Carlos-Santos-prog/Beatmaker/mecanica/BeatMaker/BeatMaker/3x4/BeatMaker_12Pads.SLDASM

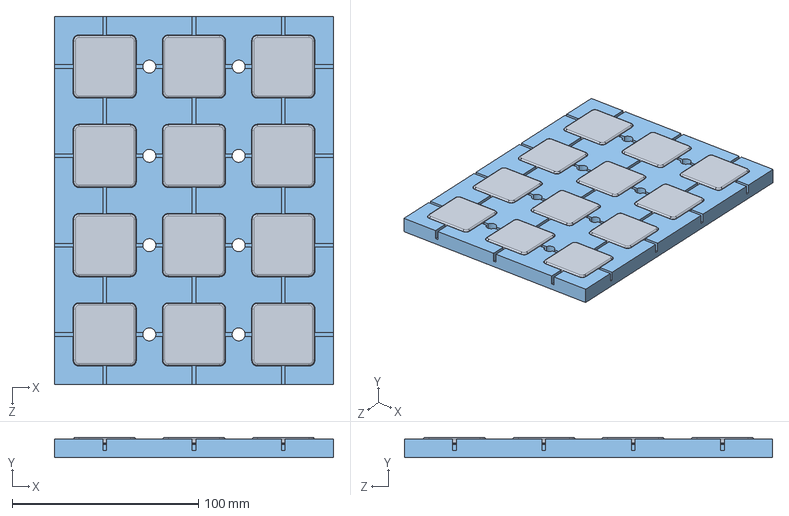
[picture p2: CAD file, 2026-11-11]
mecanica/BeatMaker/BeatMaker/3x4/BeatMaker_12Pads.SLDASM
150.0 x 11.0 x 198.0 mm
BasePiezoElectricos12
Piezoelectric Disc_ x 12
BotonPrueba x 12
