Carlos-Santos-prog/Beatmaker/mecanica/BeatMaker/BeatMaker/4x4/BeatMaker_16Pads.SLDASM

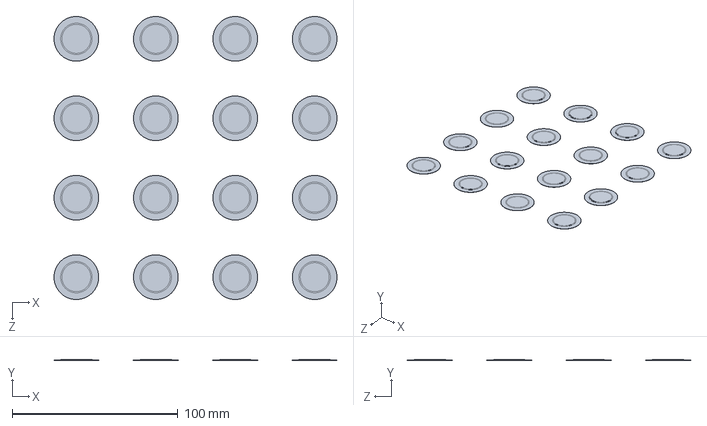
[picture p3: CAD file, 2026-11-11]
mecanica/BeatMaker/BeatMaker/4x4/BeatMaker_16Pads.SLDASM
171.0 x 0.3 x 171.0 mm
Piezoelectric Disc_ x 16
