Carlos-Santos-prog/Beatmaker/mecanica/BeatMaker/BeatMaker/Prueba/Prueba.SLDASM

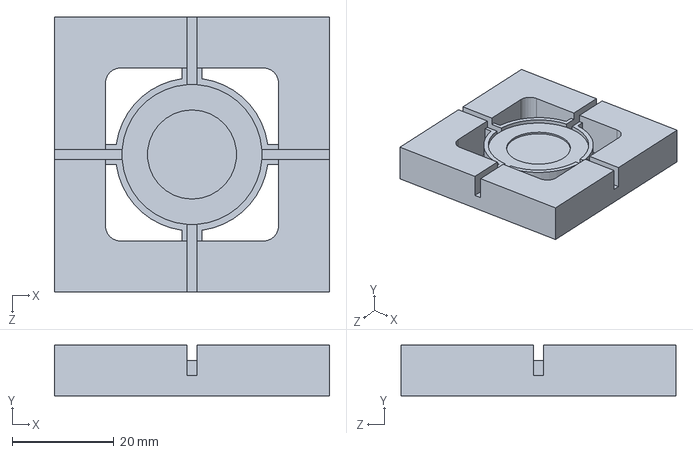
[picture p4: CAD file, 2026-11-11]
mecanica/BeatMaker/BeatMaker/Prueba/Prueba.SLDASM
54.0 x 10.0 x 54.0 mm
