Carlos-Santos-prog/Beatmaker/hardware/Fisico_00.DXF

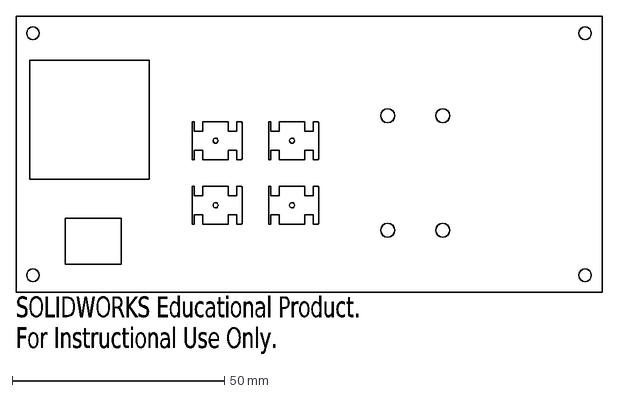
[picture p5: CAD file, 2026-11-13]
hardware/Fisico_00.DXF
SOLIDWORKS Educational Product.
For Instructional Use Only.
