Carlos-Santos-prog/Beatmaker/mecanica/0-96-oled-display-1.snapshot.1/0,96'' OLED Display.step

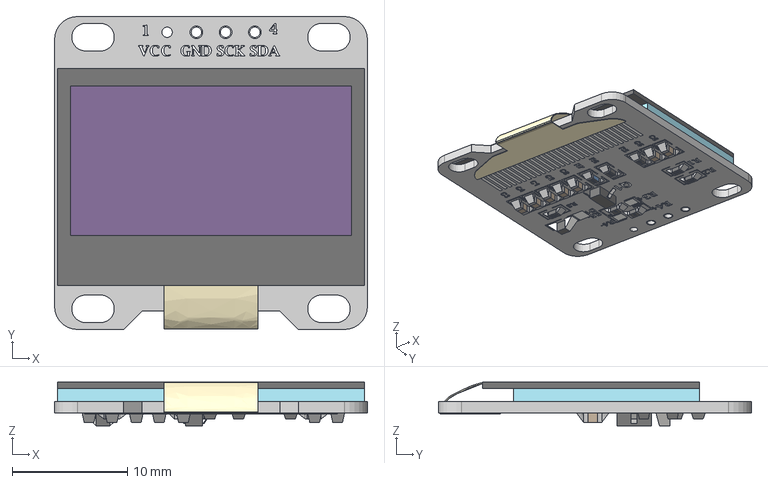
[picture p6: CAD file, 2026-11-11]
mecanica/0-96-oled-display-1.snapshot.1/0,96'' OLED Display.step
27.2 x 27.2 x 3.79 mm
