Carlos-Santos-prog/Beatmaker/mecanica/9mm-insulated-shaft-potentiometer-vertical-type-1.snapshot.5/models3d/Potentiometers/R-0904N-L-20KS-black.step

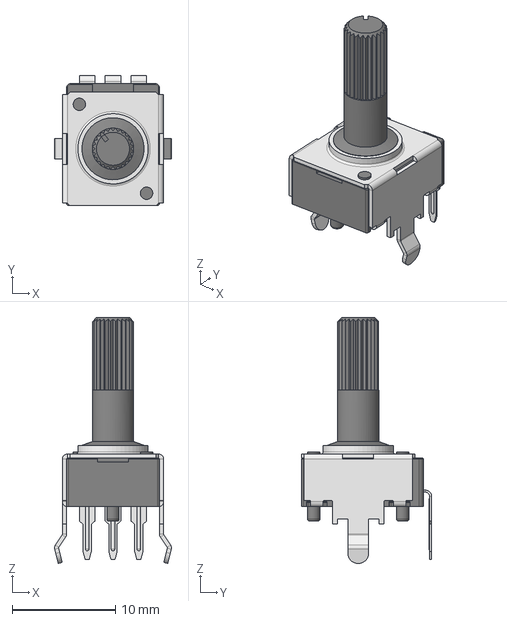
[picture p7: CAD file, 2026-11-11]
mecanica/9mm-insulated-shaft-potentiometer-vertical-type-1.snapshot.5/models3d/Potentiometers/R-0904N-L-20KS-black.step
11.3 x 12.6 x 23.8 mm
