Carlos-Santos-prog/Beatmaker/mecanica/BeatMaker/BeatMaker/Case.SLDPRT

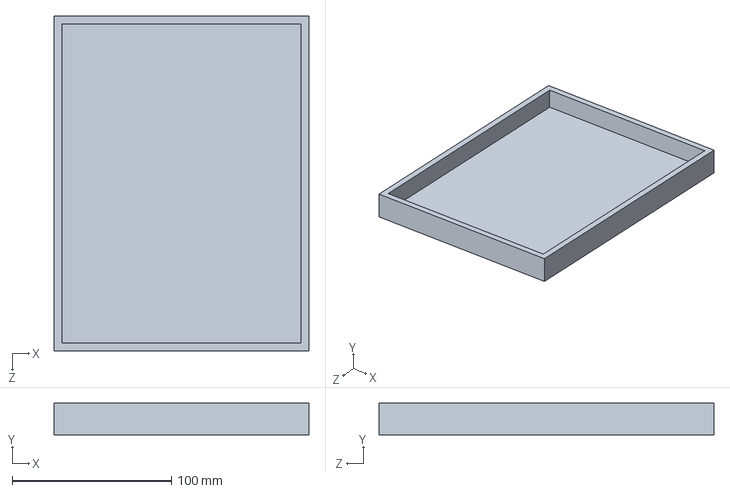
[picture p8: CAD file, 2026-11-11]
mecanica/BeatMaker/BeatMaker/Case.SLDPRT
160.0 x 20.0 x 210.0 mm
