Carlos-Santos-prog/Beatmaker/mecanica/BeatMaker/BeatMaker/Prueba/BotonPrueba.SLDPRT

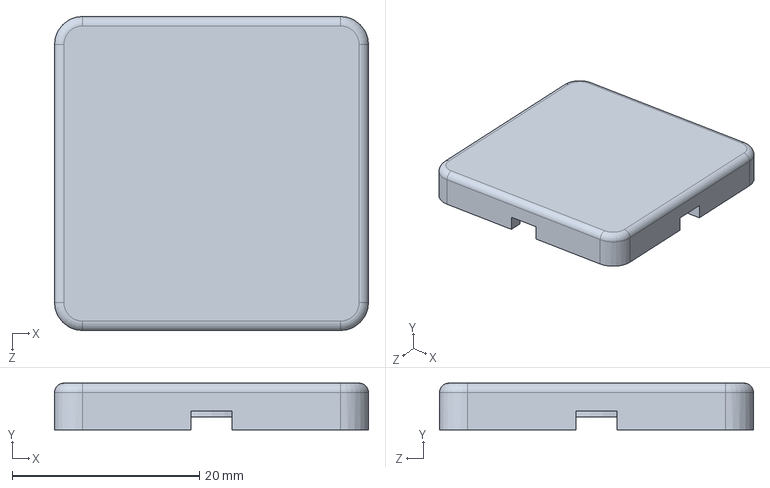
[picture p9: CAD file, 2026-11-11]
mecanica/BeatMaker/BeatMaker/Prueba/BotonPrueba.SLDPRT
33.5 x 5.00 x 33.5 mm
