Carlos-Santos-prog/Beatmaker/mecanica/rotary-encoders-1.snapshot.1/rotary+encoder_14mm_hole_spc.stp

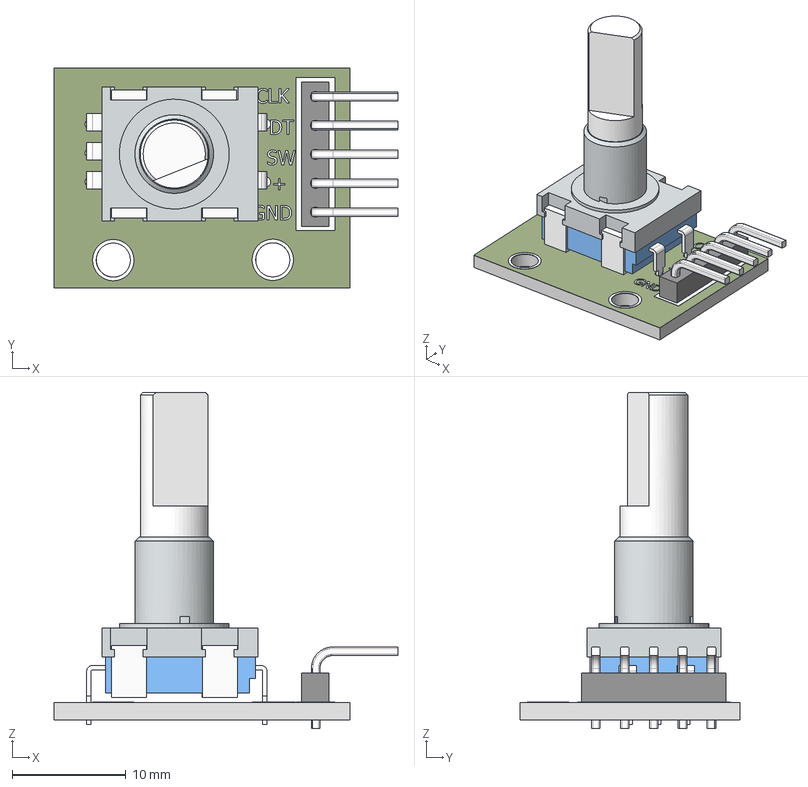
[picture p10: CAD file, 2026-11-11]
mecanica/rotary-encoders-1.snapshot.1/rotary+encoder_14mm_hole_spc.stp
30.2 x 19.3 x 29.6 mm
pcb
mtg flange
body_encoder
5 pin header
90d pin_header x 5
decal_encoder
pins_encoder body_2 x 5
shaft_encoder
