Carlos-Santos-prog/Beatmaker/mecanica/BeatMaker/BeatMaker/3x4/BasePiezoElectricos12.SLDPRT

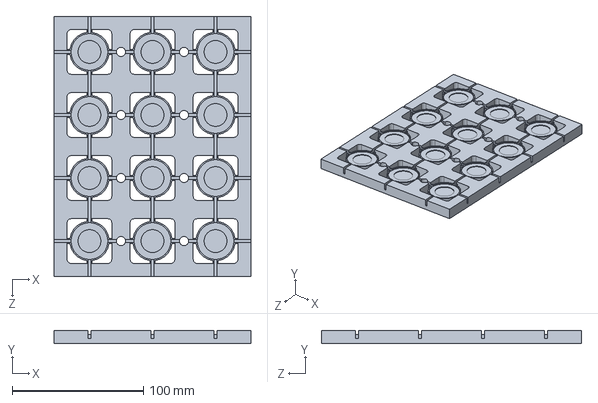
[picture p11: CAD file, 2026-11-11]
mecanica/BeatMaker/BeatMaker/3x4/BasePiezoElectricos12.SLDPRT
150.0 x 10.0 x 198.0 mm
