Carlos-Santos-prog/Beatmaker/mecanica/BeatMaker/BeatMaker/4x4/BasePiezoElectricos16.SLDPRT

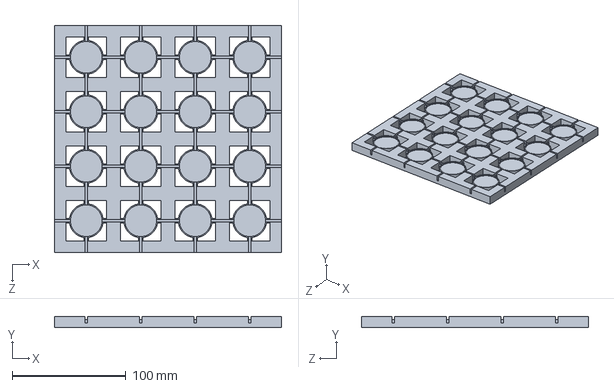
[picture p12: CAD file, 2026-11-11]
mecanica/BeatMaker/BeatMaker/4x4/BasePiezoElectricos16.SLDPRT
200.0 x 10.0 x 200.0 mm
