Carlos-Santos-prog/Beatmaker/mecanica/BeatMaker/BeatMaker/Piezoelectric Disc_.SLDPRT

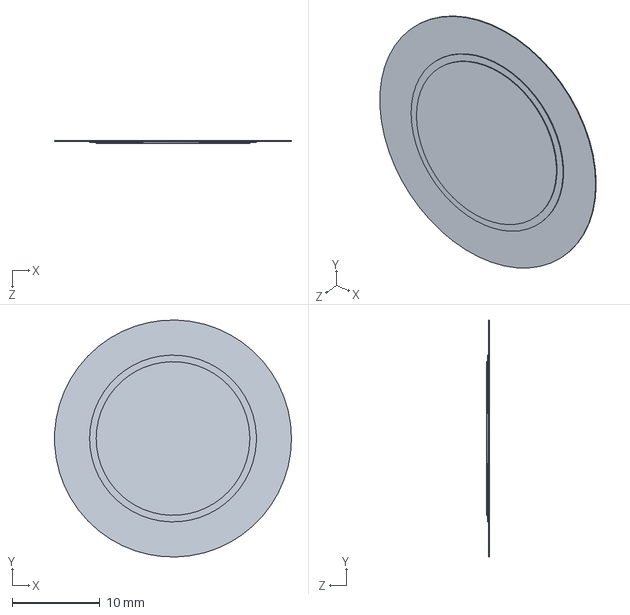
[picture p13: CAD file, 2026-11-11]
mecanica/BeatMaker/BeatMaker/Piezoelectric Disc_.SLDPRT
27.0 x 27.0 x 0.3 mm
