Carlos-Santos-prog/Beatmaker/mecanica/Calcasa.SLDPRT

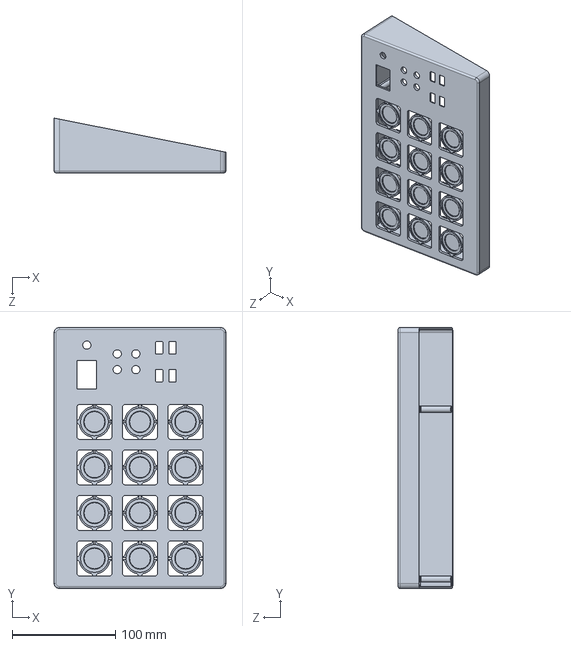
[picture p14: CAD file, 2026-11-13]
mecanica/Calcasa.SLDPRT
166.0 x 252.2 x 53.0 mm
