Carlos-Santos-prog/Beatmaker/mecanica/BeatMaker/BeatMaker/3x4/Boton.SLDPRT

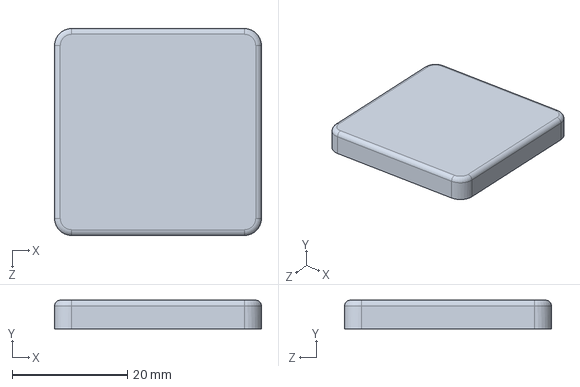
[picture p15: CAD file, 2026-11-11]
mecanica/BeatMaker/BeatMaker/3x4/Boton.SLDPRT
36.0 x 5.00 x 36.0 mm
