Carlos-Santos-prog/Beatmaker/mecanica/GomaBoton.SLDPRT

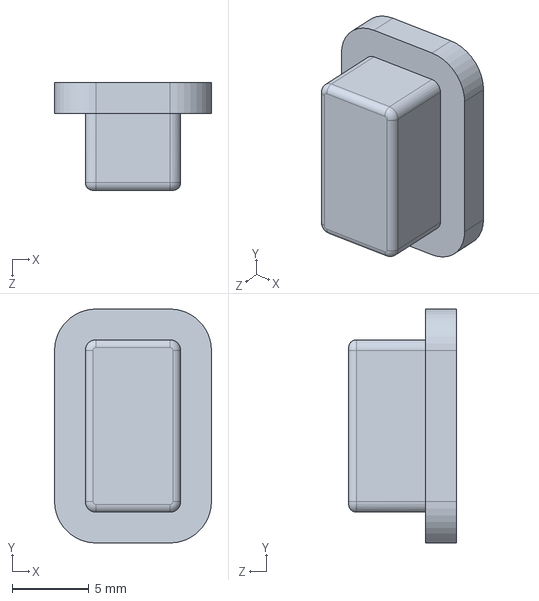
[picture p16: CAD file, 2026-11-11]
mecanica/GomaBoton.SLDPRT
10.2 x 15.2 x 7.00 mm
