Carlos-Santos-prog/Beatmaker/mecanica/Fisico_00.SLDASM

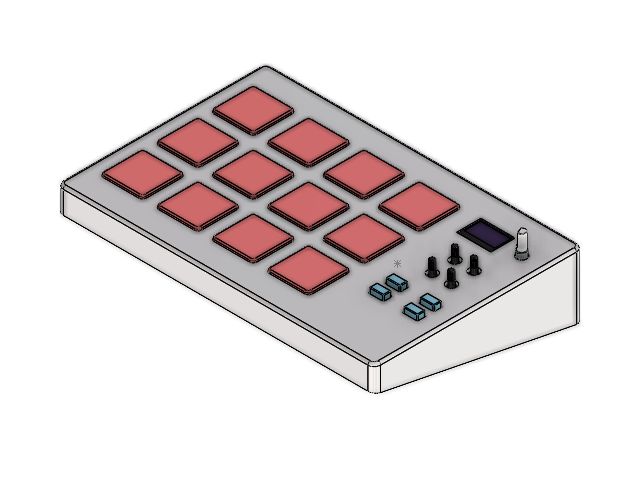
[picture p17: CAD file, 2026-11-13]
mecanica/Fisico_00.SLDASM
Calcasa
pcb.step
eBom-FreeParts.step
mtg flange.stp
body_encoder.stp
body_2.stp x 4
pins_encoder body_2.stp x 5
shaft_encoder.stp
R-0904N-L-20KS.step x 4
GomaBoton x 4
BotonPrueba x 12
Piezoelectric Disc_
