Carlos-Santos-prog/Beatmaker/(list of files, cad)

Other CAD files:
mecanica/9mm-insulated-shaft-potentiometer-vertical-type-1.snapshot.5/models3d/Potentiometers/R-0904N-L-20KS.step
mecanica/BeatMaker/BeatMaker/Prueba/BasePiezoPrueba.SLDPRT
mecanica/9mm-insulated-shaft-potentiometer-vertical-type-1.snapshot.5/models3d/Potentiometers/R-0904N-L-20KS-green.step
