Carlos-Santos-prog/Beatmaker/hardware/Indutrial/Indutrial.kicad_pcb

## KiCad design hardware/Indutrial/Indutrial.kicad_pcb (2026-11-13)

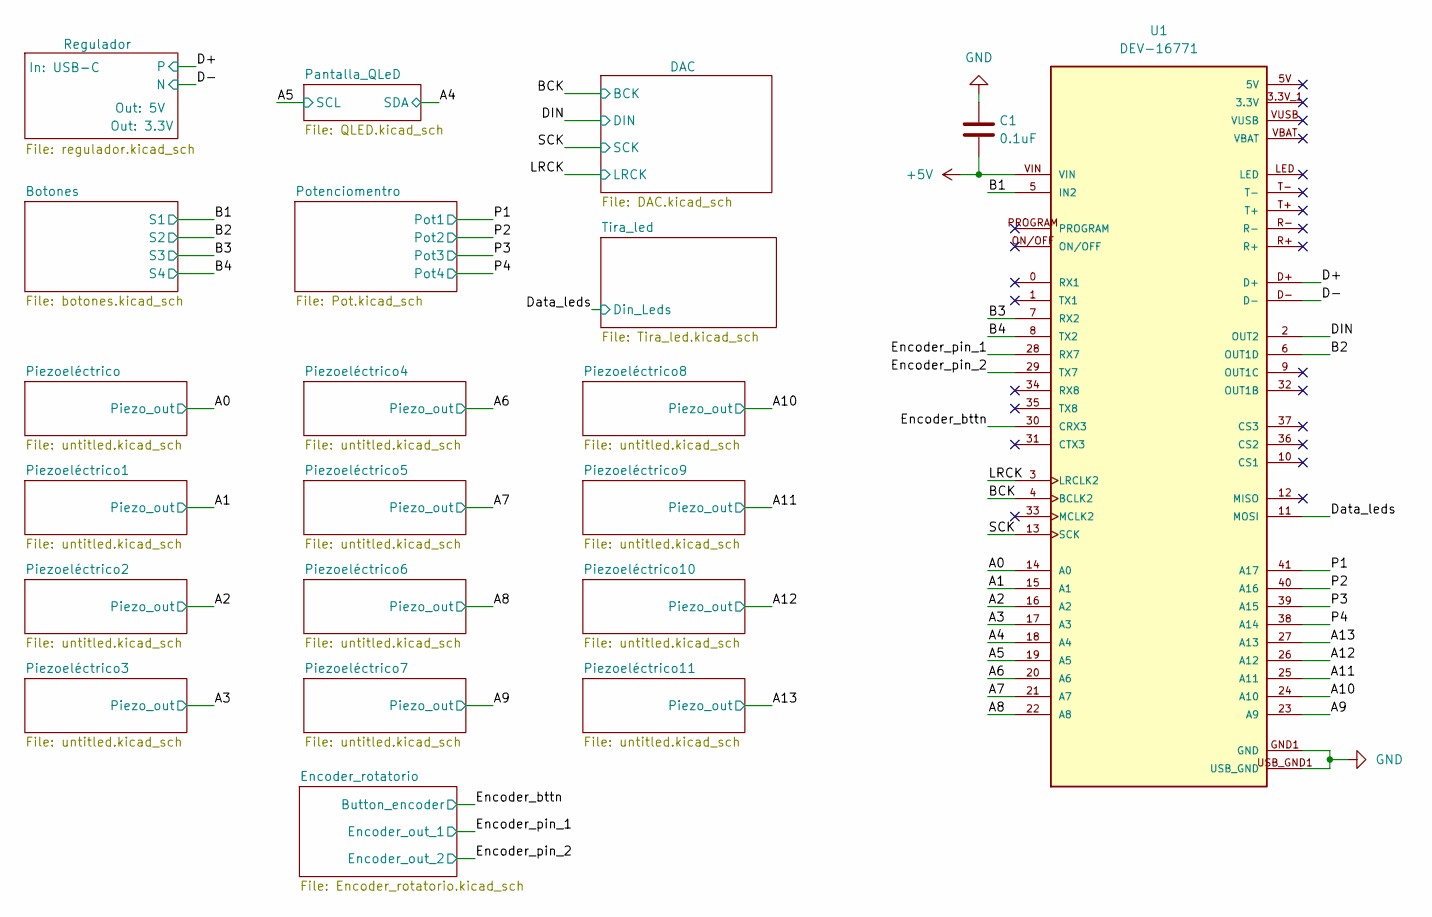
[picture p24: schematic Indutrial.kicad_sch]

Parts:
C1: 0.1uF; C_0603_1608Metric
U1: DEV-16771; MODULE_DEV-16771; MPN DEV-16771

Connections:
+5V: C1.2, U1.VIN; also elsewhere on the board
/A0: U1.14 (A0); also elsewhere on the board
/A1: U1.15 (A1); also elsewhere on the board
/A2: U1.16 (A2); also elsewhere on the board
/A3: U1.17 (A3); also elsewhere on the board
/A4: U1.18 (A4); also elsewhere on the board
/A5: U1.19 (A5); also elsewhere on the board
/A6: U1.20 (A6); also elsewhere on the board
/A7: U1.21 (A7); also elsewhere on the board
/A8: U1.22 (A8); also elsewhere on the board
/A9: U1.23 (A9); also elsewhere on the board
/A10: U1.24 (A10); also elsewhere on the board
/A11: U1.25 (A11); also elsewhere on the board
/A12: U1.26 (A12); also elsewhere on the board
/A13: U1.27 (A13); also elsewhere on the board
/B1: U1.5 (IN2); also elsewhere on the board
/B2: U1.6 (OUT1D); also elsewhere on the board
/B3: U1.7 (RX2); also elsewhere on the board
/B4: U1.8 (TX2); also elsewhere on the board
/BCK: U1.4 (BCLK2); also elsewhere on the board
/D+: U1.D+; also elsewhere on the board
/D-: U1.D-; also elsewhere on the board
/DIN: U1.2 (OUT2); also elsewhere on the board
/Data_leds: U1.11 (MOSI); also elsewhere on the board
/Encoder_bttn: U1.30 (CRX3); also elsewhere on the board
/Encoder_pin_1: U1.28 (RX7); also elsewhere on the board
/Encoder_pin_2: U1.29 (TX7); also elsewhere on the board
/LRCK: U1.3 (LRCLK2); also elsewhere on the board
/P1: U1.41 (A17); also elsewhere on the board
/P2: U1.40 (A16); also elsewhere on the board
/P3: U1.39 (A15); also elsewhere on the board
/P4: U1.38 (A14); also elsewhere on the board
/SCK: U1.13 (SCK); also elsewhere on the board
GND: C1.1, U1.GND1 (GND), U1.GND2 (GND), U1.GND3 (GND), U1.GND4 (GND), U1.GND5 (GND), U1.USB_GND1 (USB_GND), U1.USB_GND2 (USB_GND); also elsewhere on the board

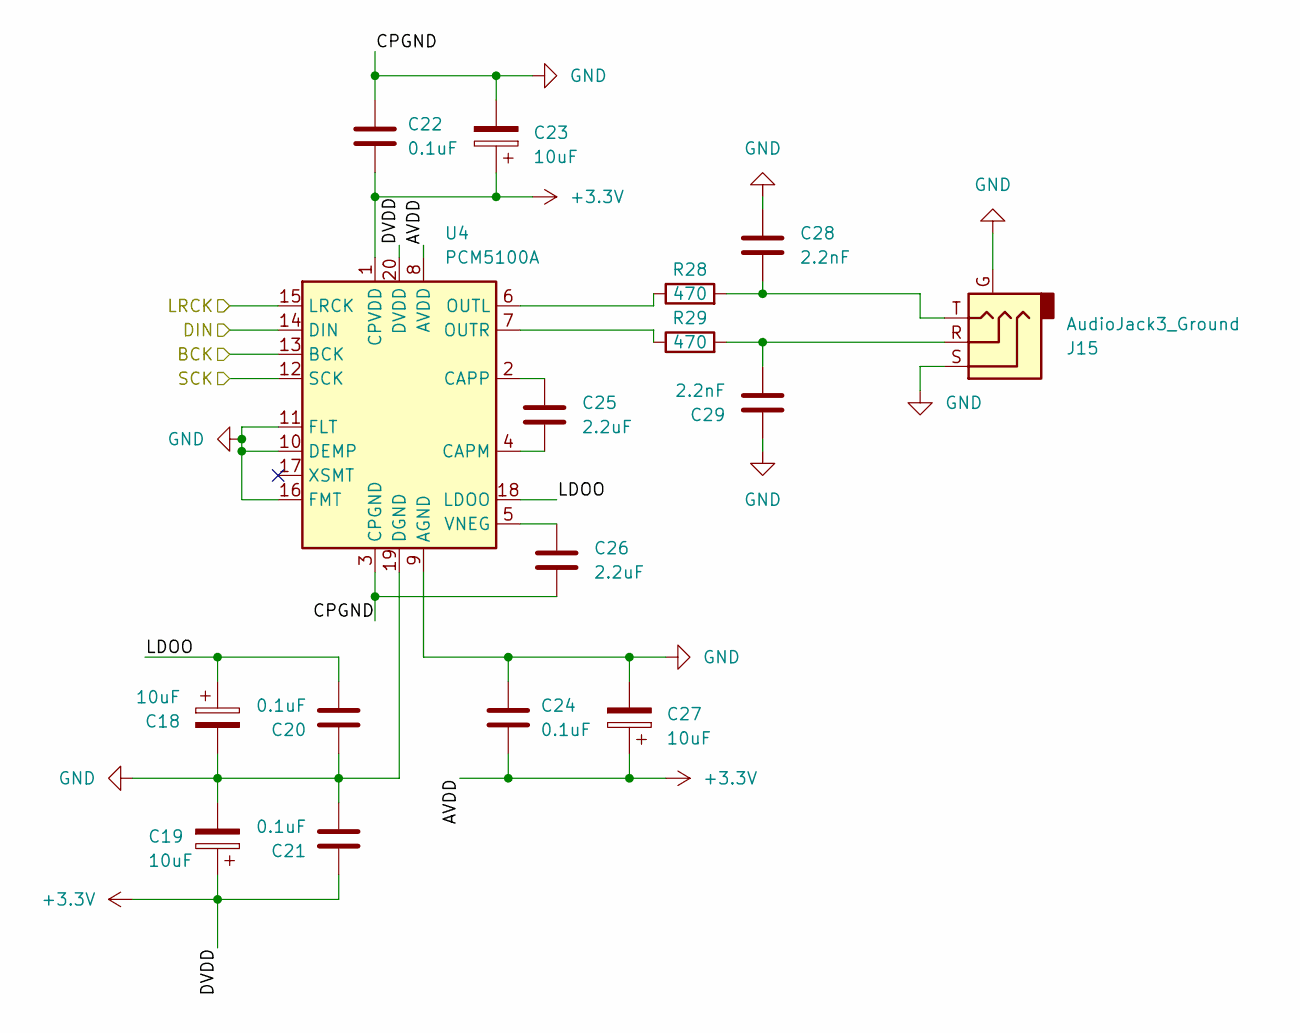
[picture p25: schematic DAC.kicad_sch]

Parts:
C18, C19: 10uF; C_1206_3216Metric
C20, C21, C22, C24: 0.1uF; C_0603_1608Metric
C23, C27: 10uF; CP_EIA-3216-18_Kemet-A
C25, C26: 2.2uF; C_0805_2012Metric
C28, C29: 2.2nF; C_0805_2012Metric_Pad1.18x1.45mm_HandSolder
J15: AudioJack3_Ground; Jack_3.5mm_CUI_SJ1-3524N_Horizontal
R28, R29: 470; R_1206_3216Metric
U4: PCM5100A; TSSOP-20_4.4x6.5mm_P0.65mm

Connections:
+3.3V: C19.1, C21.2, C22.1, C23.1, C24.1, C27.1, U4.1 (CPVDD), U4.8 (AVDD), U4.20 (DVDD); also elsewhere on the board
/BCK: U4.13 (BCK); also elsewhere on the board
/DAC/LDOO: C18.1, C20.1, U4.18 (LDOO)
/DIN: U4.14 (DIN); also elsewhere on the board
/LRCK: U4.15 (LRCK); also elsewhere on the board
/SCK: U4.12 (SCK); also elsewhere on the board
GND: C18.2, C19.2, C20.2, C21.1, C22.2, C23.2, C24.2, C26.1, C27.2, C28.1, C29.1, J15.G, J15.S, U4.3 (CPGND), U4.9 (AGND), U4.10 (DEMP), U4.11 (FLT), U4.16 (FMT), U4.19 (DGND); also elsewhere on the board
unnamed: C28.2, J15.T, R28.2
unnamed: C29.2, J15.R, R29.2
unnamed: C25.1, U4.4 (CAPM)
unnamed: C25.2, U4.2 (CAPP)
unnamed: R28.1, U4.6 (OUTL)
unnamed: R29.1, U4.7 (OUTR)
unnamed: C26.2, U4.5 (VNEG)

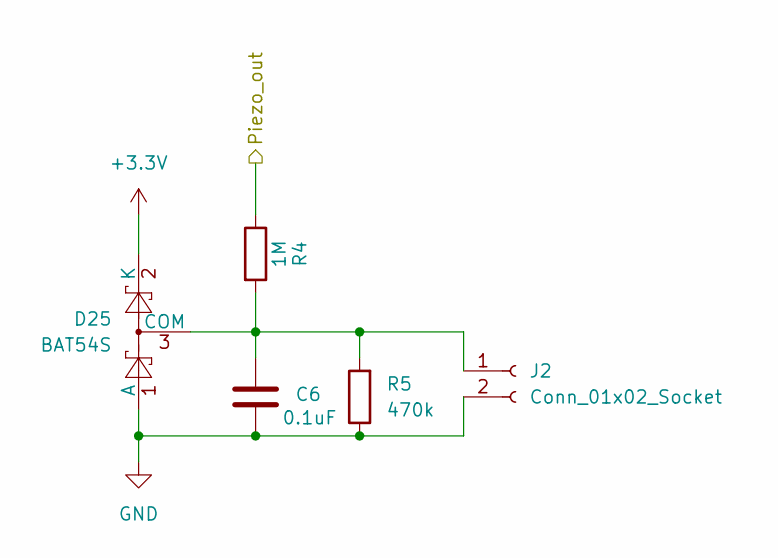
[picture p26: schematic untitled.kicad_sch]

Parts:
C6: 0.1uF; C_0603_1608Metric
D25: BAT54S; SOT-23
J2: Conn_01x02_Socket; SolderWire-0.1sqmm_1x02_P3.6mm_D0.4mm_OD1mm
R4: 1M; R_0603_1608Metric
R5: 470k; R_0603_1608Metric

Connections:
+3.3V: D25.2 (K); also elsewhere on the board
/A0: R4.1; also elsewhere on the board
GND: C6.2, D25.1 (A), J2.2, R5.1; also elsewhere on the board
unnamed: C6.1, D25.3 (COM), J2.1, R4.2, R5.2

Parts of its further copies:
C7, C8, C9, C10, C11, C12, C13, C14, C15, C16, C17: 0.1uF; C_0603_1608Metric
D26, D27, D28, D29, D30, D31, D32, D33, D34, D35, D36: BAT54S; SOT-23
J3, J4, J5, J6, J7, J8, J9, J10, J11, J12, J13: Conn_01x02_Socket; SolderWire-0.1sqmm_1x02_P3.6mm_D0.4mm_OD1mm
R6, R8, R10, R12, R14, R16, R18, R20, R22, R24, R26: 1M; R_0603_1608Metric
R7, R9, R11, R13, R15, R17, R19, R21, R23, R25, R27: 470k; R_0603_1608Metric

Connections of its further copies:
+3.3V: D26.2 (K), D27.2 (K), D28.2 (K), D29.2 (K), D30.2 (K), D31.2 (K), D32.2 (K), D33.2 (K), D34.2 (K), D35.2 (K), D36.2 (K); also elsewhere on the board
/A1: R6.1; also elsewhere on the board
/A2: R8.1; also elsewhere on the board
/A3: R10.1; also elsewhere on the board
/A6: R12.1; also elsewhere on the board
/A7: R14.1; also elsewhere on the board
/A8: R16.1; also elsewhere on the board
/A9: R18.1; also elsewhere on the board
/A10: R20.1; also elsewhere on the board
/A11: R22.1; also elsewhere on the board
/A12: R24.1; also elsewhere on the board
/A13: R26.1; also elsewhere on the board
GND: C7.2, C8.2, C9.2, C10.2, C11.2, C12.2, C13.2, C14.2, C15.2, C16.2, C17.2, D26.1 (A), D27.1 (A), D28.1 (A), D29.1 (A), D30.1 (A), D31.1 (A), D32.1 (A), D33.1 (A), D34.1 (A), D35.1 (A), D36.1 (A), J3.2, J4.2, J5.2, J6.2, J7.2, J8.2, J9.2, J10.2, J11.2, J12.2, J13.2, R7.1, R9.1, R11.1, R13.1, R15.1, R17.1, R19.1, R21.1, R23.1, R25.1, R27.1; also elsewhere on the board
unnamed: C7.1, D26.3 (COM), J3.1, R6.2, R7.2
unnamed: C8.1, D27.3 (COM), J4.1, R8.2, R9.2
unnamed: C9.1, D28.3 (COM), J5.1, R10.2, R11.2
unnamed: C10.1, D29.3 (COM), J6.1, R12.2, R13.2
unnamed: C11.1, D30.3 (COM), J7.1, R14.2, R15.2
unnamed: C12.1, D31.3 (COM), J8.1, R16.2, R17.2
unnamed: C13.1, D32.3 (COM), J9.1, R18.2, R19.2
unnamed: C14.1, D33.3 (COM), J10.1, R20.2, R21.2
unnamed: C15.1, D34.3 (COM), J11.1, R22.2, R23.2
unnamed: C16.1, D35.3 (COM), J12.1, R24.2, R25.2
unnamed: C17.1, D36.3 (COM), J13.1, R26.2, R27.2

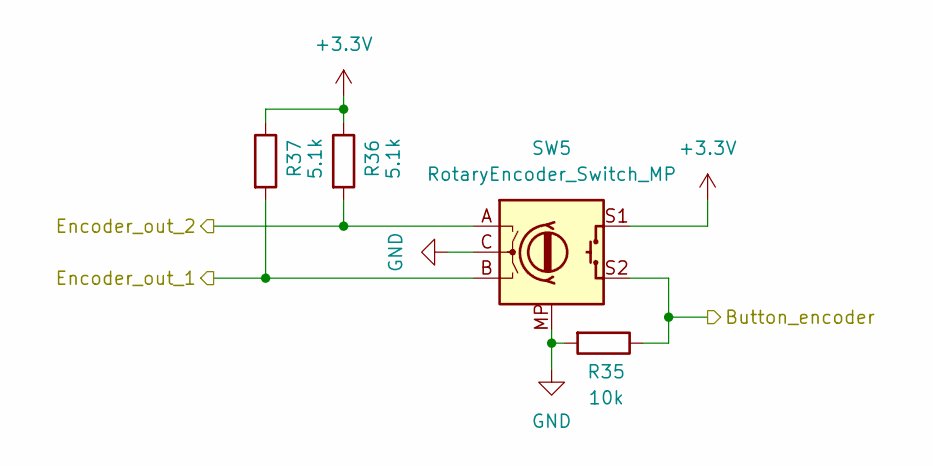
[picture p27: schematic Encoder_rotatorio.kicad_sch]

Parts:
R35: 10k; R_0603_1608Metric
R36, R37: 5.1k; R_0603_1608Metric
SW5: RotaryEncoder_Switch_MP; RotaryEncoder_Alps_EC11E-Switch_Vertical_H20mm

Connections:
+3.3V: R36.1, R37.1, SW5.S1; also elsewhere on the board
/Encoder_bttn: R35.1, SW5.S2; also elsewhere on the board
/Encoder_pin_1: R37.2, SW5.B; also elsewhere on the board
/Encoder_pin_2: R36.2, SW5.A; also elsewhere on the board
GND: R35.2, SW5.C, SW5.MP; also elsewhere on the board

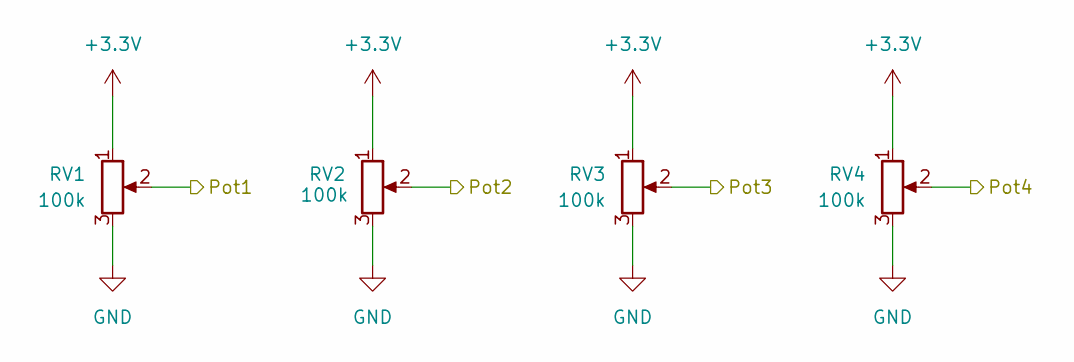
[picture p28: schematic Pot.kicad_sch]

Parts:
RV1, RV2, RV3, RV4: 100k; Potentiometer_Alpha_RD901F-40-00D_Single_Vertical

Connections:
+3.3V: RV1.1, RV2.1, RV3.1, RV4.1; also elsewhere on the board
/P1: RV1.2; also elsewhere on the board
/P2: RV2.2; also elsewhere on the board
/P3: RV3.2; also elsewhere on the board
/P4: RV4.2; also elsewhere on the board
GND: RV1.3, RV2.3, RV3.3, RV4.3; also elsewhere on the board

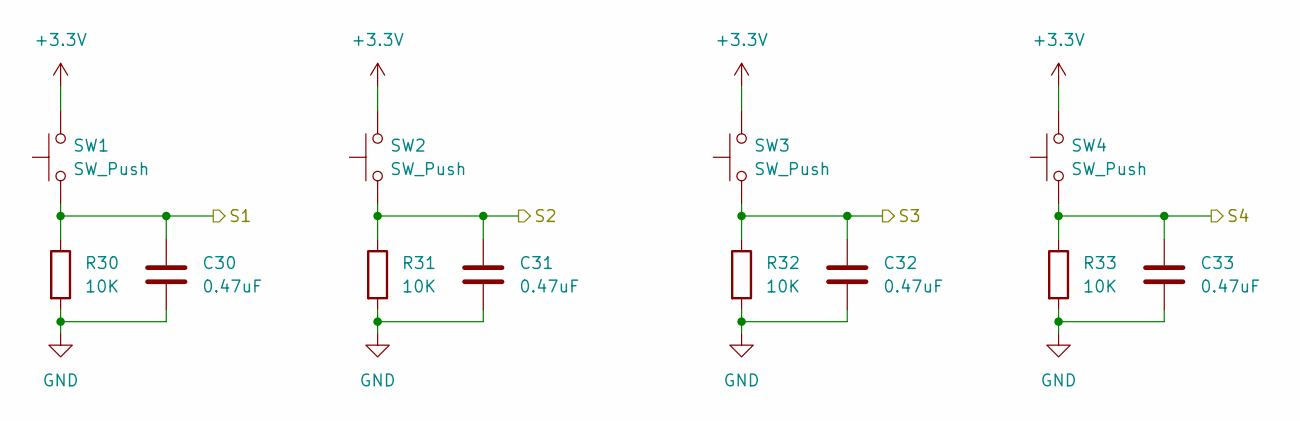
[picture p29: schematic botones.kicad_sch]

Parts:
C30, C31, C32, C33: 0.47uF; C_0805_2012Metric
R30, R31, R32, R33: 10K; R_0805_2012Metric
SW1, SW2, SW3, SW4: SW_Push; SW_PUSH_6mm

Connections:
+3.3V: SW1.2, SW2.2, SW3.2, SW4.2; also elsewhere on the board
/B1: C30.1, R30.1, SW1.1; also elsewhere on the board
/B2: C31.1, R31.1, SW2.1; also elsewhere on the board
/B3: C32.1, R32.1, SW3.1; also elsewhere on the board
/B4: C33.1, R33.1, SW4.1; also elsewhere on the board
GND: C30.2, C31.2, C32.2, C33.2, R30.2, R31.2, R32.2, R33.2; also elsewhere on the board

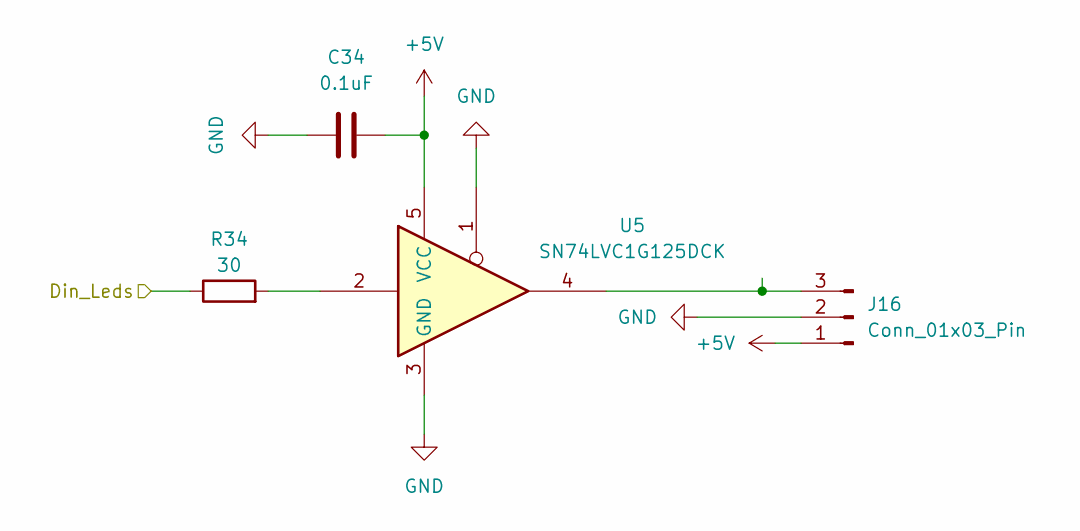
[picture p30: schematic Tira_led.kicad_sch]

Parts:
C34: 0.1uF; C_0805_2012Metric
J16: Conn_01x03_Pin; JST_EH_B3B-EH-A_1x03_P2.50mm_Vertical
R34: 30; R_1206_3216Metric
U5: SN74LVC1G125DCK; Texas_R-PDSO-G5_DCK-5

Connections:
+5V: C34.1, J16.1, U5.5 (VCC); also elsewhere on the board
/Data_leds: R34.1; also elsewhere on the board
GND: C34.2, J16.2, U5.1, U5.3 (GND); also elsewhere on the board
unnamed: J16.3, U5.4
unnamed: R34.2, U5.2

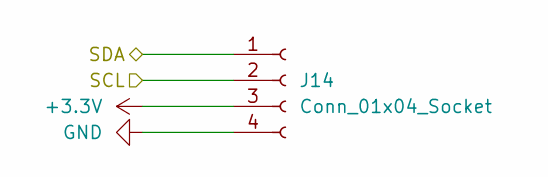
[picture p31: schematic QLED.kicad_sch]

Parts:
J14: Conn_01x04_Socket; PinSocket_1x04_P2.54mm_Vertical

Connections:
+3.3V: J14.3; also elsewhere on the board
/A4: J14.1; also elsewhere on the board
/A5: J14.2; also elsewhere on the board
GND: J14.4; also elsewhere on the board

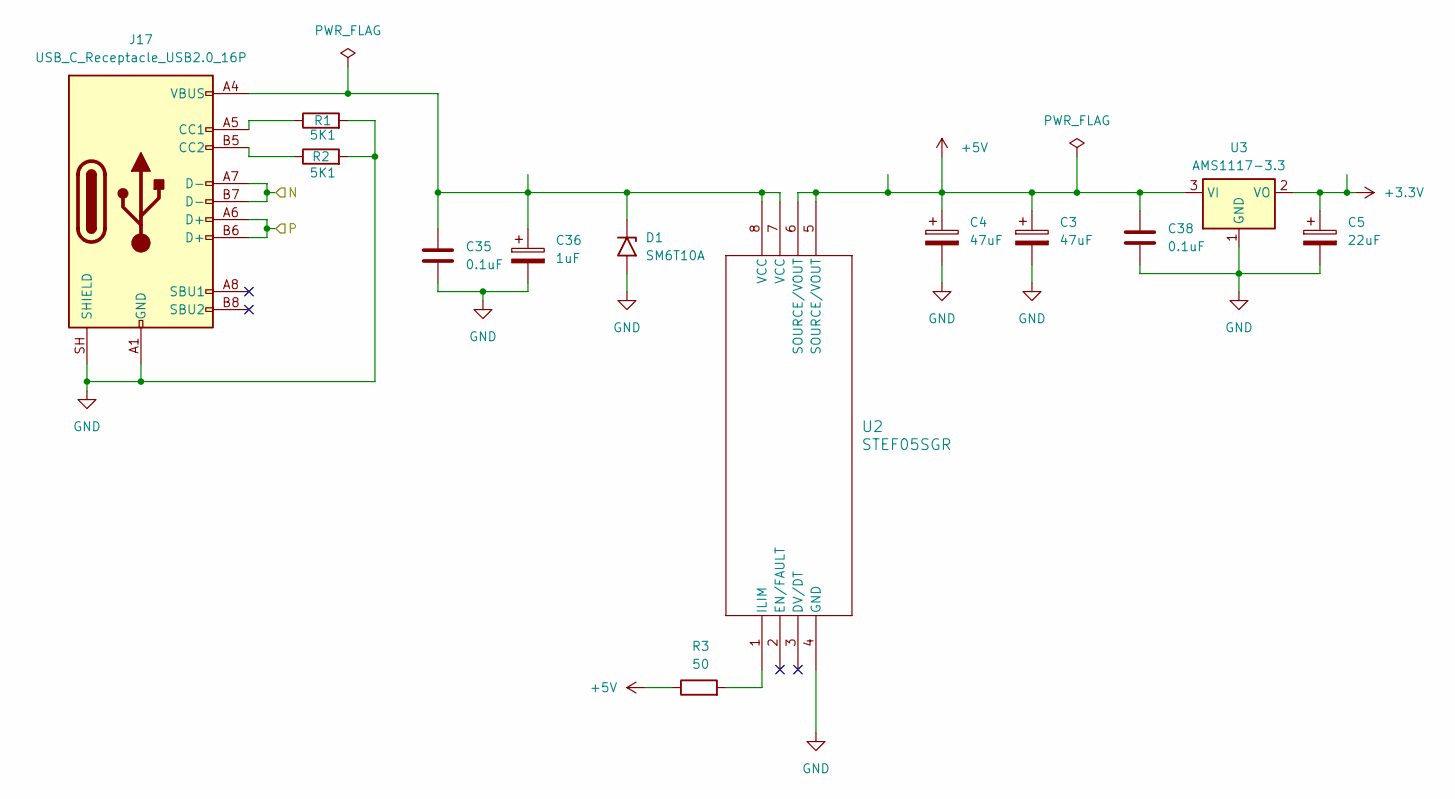
[picture p32: schematic regulador.kicad_sch]

Parts:
C3, C4: 47uF; CP_Elec_5x5.4
C5: 22uF; CP_Elec_4x4.5
C35, C38: 0.1uF; C_0805_2012Metric
C36: 1uF; CP_EIA-3216-18_Kemet-A
D1: SM6T10A; Nexperia_DSN1608-2_1.6x0.8mm
J17: USB_C_Receptacle_USB2.0_16P; USB_C_Receptacle_G-Switch_GT-USB-7010ASV
R1, R2: 5K1; R_0805_2012Metric
R3: 50; R_0805_2012Metric
U2: STEF05SGR; TSOT23-8L_STM
U3: AMS1117-3.3; SOT-223-3_TabPin2

Connections:
+3.3V: C5.1, U3.2 (VO); also elsewhere on the board
+5V: C3.1, C4.1, C38.1, R3.1, U2.5 (SOURCE/VOUT), U2.6 (SOURCE/VOUT), U3.3 (VI); also elsewhere on the board
/D+: J17.A6 (D+), J17.B6 (D+); also elsewhere on the board
/D-: J17.A7 (D-), J17.B7 (D-); also elsewhere on the board
GND: C3.2, C4.2, C5.2, C35.2, C36.2, C38.2, D1.2 (A2), J17.A1 (GND), J17.A12 (GND), J17.B1 (GND), J17.B12 (GND), J17.SH (SHIELD), R1.2, R2.2, U2.4 (GND), U3.1 (GND); also elsewhere on the board
unnamed: C35.1, C36.1, D1.1 (A1), J17.A4 (VBUS), J17.A9 (VBUS), J17.B4 (VBUS), J17.B9 (VBUS), U2.7 (VCC), U2.8 (VCC)
unnamed: J17.A5 (CC1), R1.1
unnamed: J17.B5 (CC2), R2.1
unnamed: R3.2, U2.1 (ILIM)

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
Board: 2 copper layers, 116 parts (10 on the bottom side), 61 nets, no tracks yet.
