Carlos-Santos-prog/Beatmaker/(commit log)

2026-10-23 Codigo de prueba funcional
    Código utilizado en la prueba con 3 piezoeléctricos, funcional como controlador MIDI.
2026-11-05 hardware: agrega proyecto KiCad Indutrial (esquematicos y PCB)
    Incluye hoja raiz Indutrial, hojas DAC, regulador y QLED, y archivos de proyecto KiCad. Se excluyen archivos temporales de KiCad mediante .gitignore.
    [DAC.kicad_sch, Indutrial.kicad_pcb, Indutrial.kicad_sch, QLED.kicad_sch, regulador.kicad_sch, untitled.kicad_sch]
2026-11-07 Detallitos
    Esquematico
    [DAC.kicad_sch, Indutrial.kicad_sch, QLED.kicad_sch, regulador.kicad_sch, untitled.kicad_sch]
2026-11-08 Maqueta 00 del proyecto
    Ensamble base para fluir con PCB y comenzar a idealizar el cableado.
    [0,96'' OLED Display.step, BasePiezoElectricos12.SLDPRT, BasePiezoElectricos16.SLDPRT, BasePiezoPrueba.SLDPRT, BeatMaker_12Pads.SLDASM, BeatMaker_16Pads.SLDASM, Boton.SLDPRT, BotonPrueba.SLDPRT]
2026-11-09 Dimensiones para PCB y modificación de carcasa.
    Ranuras para organización de cableado y salientes para atornillar carcasa.
    [Calcasa.SLDPRT, Fisico_00.SLDASM]
2026-11-10 detallito en carcasa
    [Calcasa.SLDPRT, DAC.kicad_sch, Indutrial.kicad_sch, regulador.kicad_sch]
2026-11-13 Aumento de Case
    De 138x65 a 158x65 para mayor tamaño en PCB
    [Calcasa.SLDPRT, Fisico_00.SLDASM]
2026-11-13 El pcb casi redi
    Agregué el encoder y la salida para los datos de la tira led. Comencé el PCB con la versión 1 del DXF del diseño, pronto la version 2.
    [DAC.kicad_sch, Encoder_rotatorio.kicad_sch, Fisico_00.DXF, Indutrial.kicad_pcb, Indutrial.kicad_sch, Pot.kicad_sch, QLED.kicad_sch, Tira_led.kicad_sch]
2026-11-13 Circuito de proteccion de alimentacion
    Se añadió el Circuito de proteccion de alimentacion completo.
    [Indutrial.kicad_pcb, regulador.kicad_sch]
